manojtharindu11/Miner-Safety-Helmet/Images/repeater.jpg

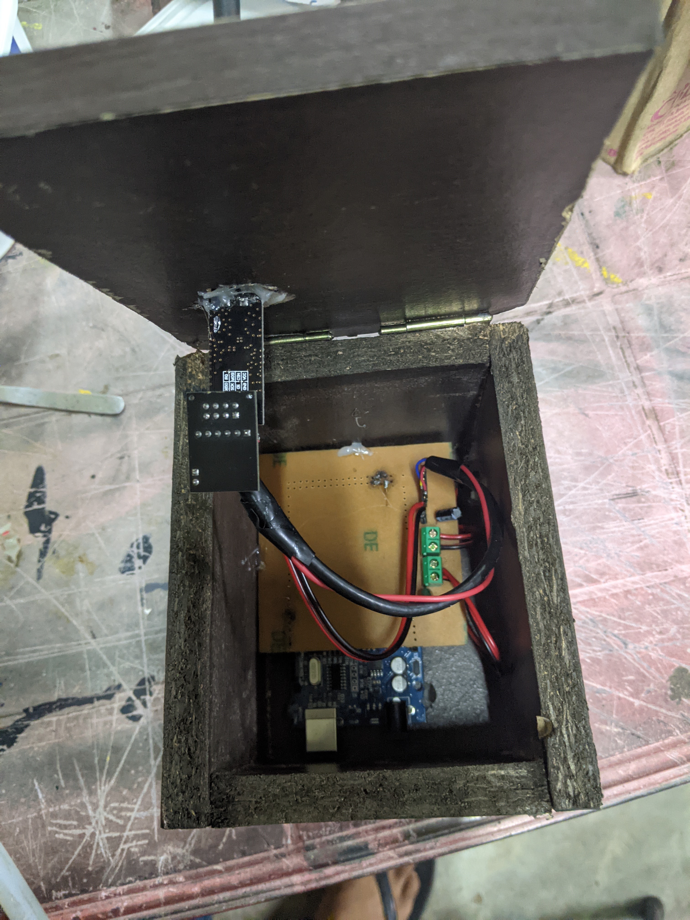
Images/repeater.jpg
