manojtharindu11/Miner-Safety-Helmet/Images/Pic1.jpg

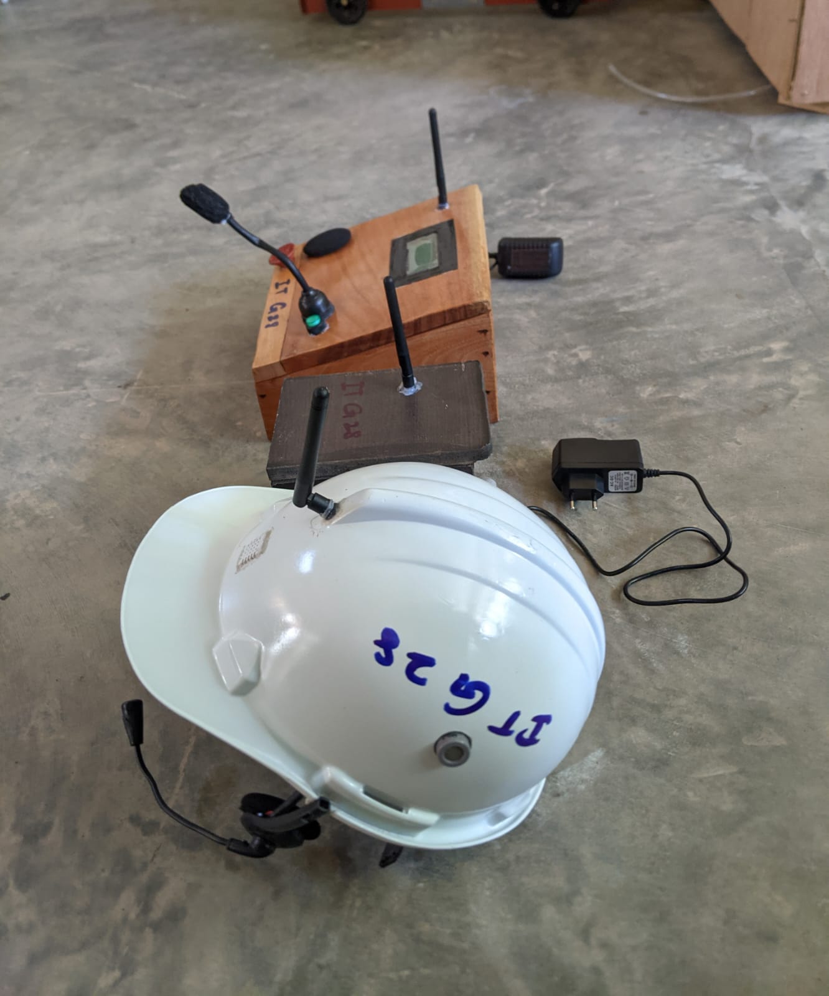
Images/Pic1.jpg
