manojtharindu11/Miner-Safety-Helmet/Images/receiver.jpg

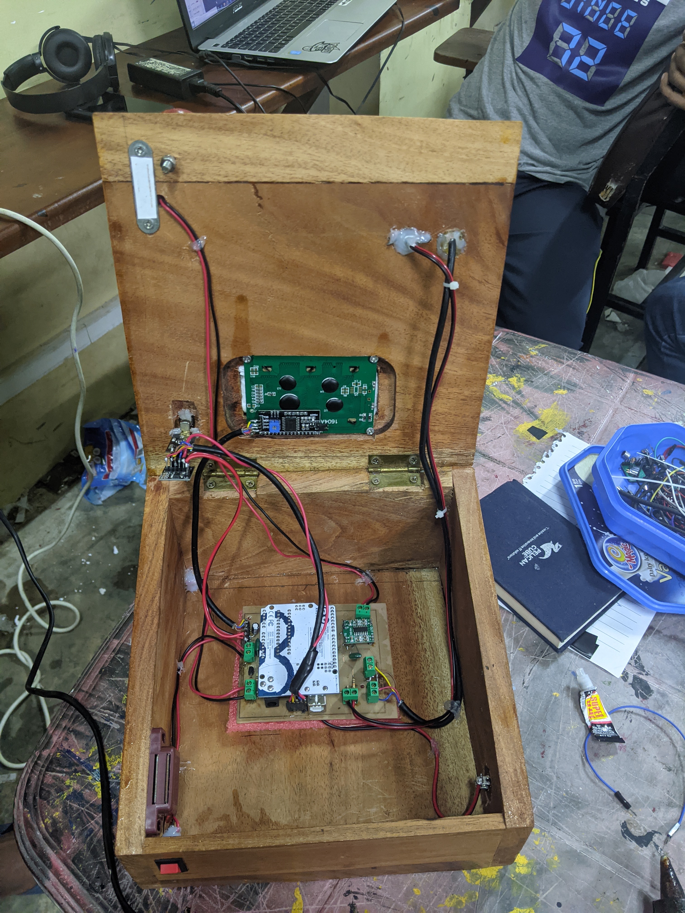
Images/receiver.jpg
