manojtharindu11/Miner-Safety-Helmet/Images/transmiter.jpg

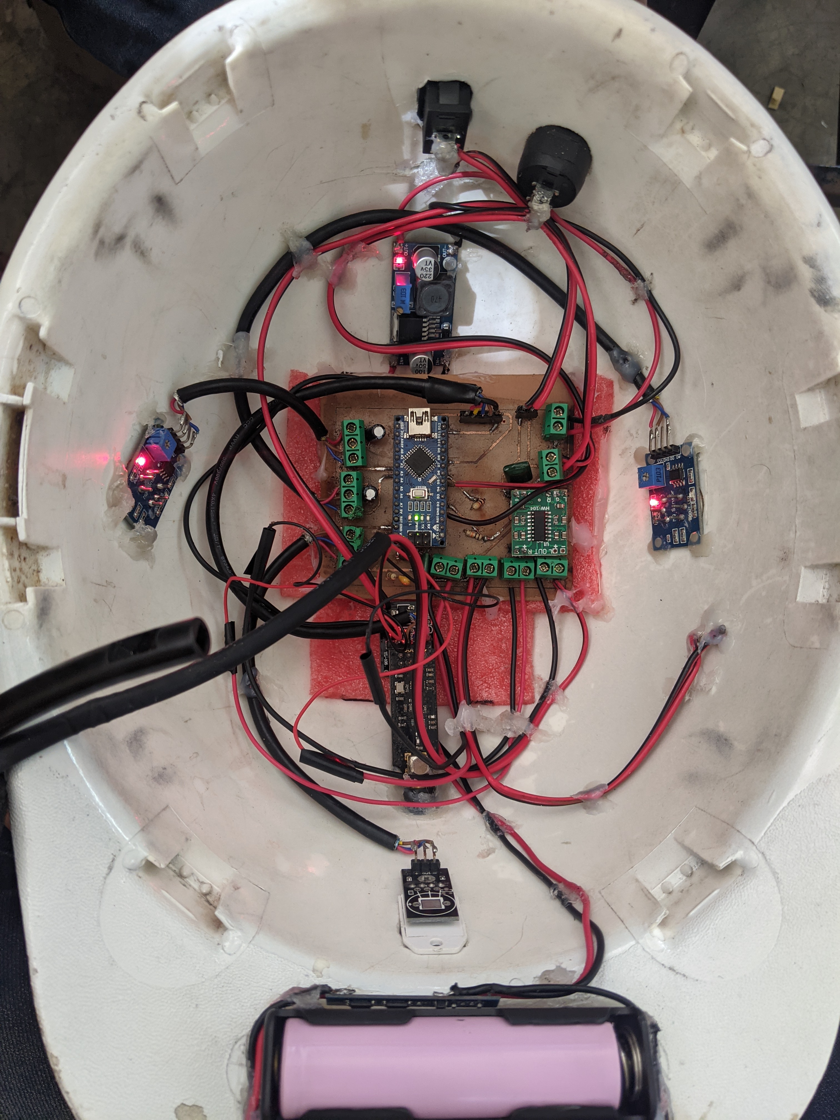
Images/transmiter.jpg
