manojtharindu11/Miner-Safety-Helmet/PCBs & Schematics/Schematic_repeater_2023-06-20.png

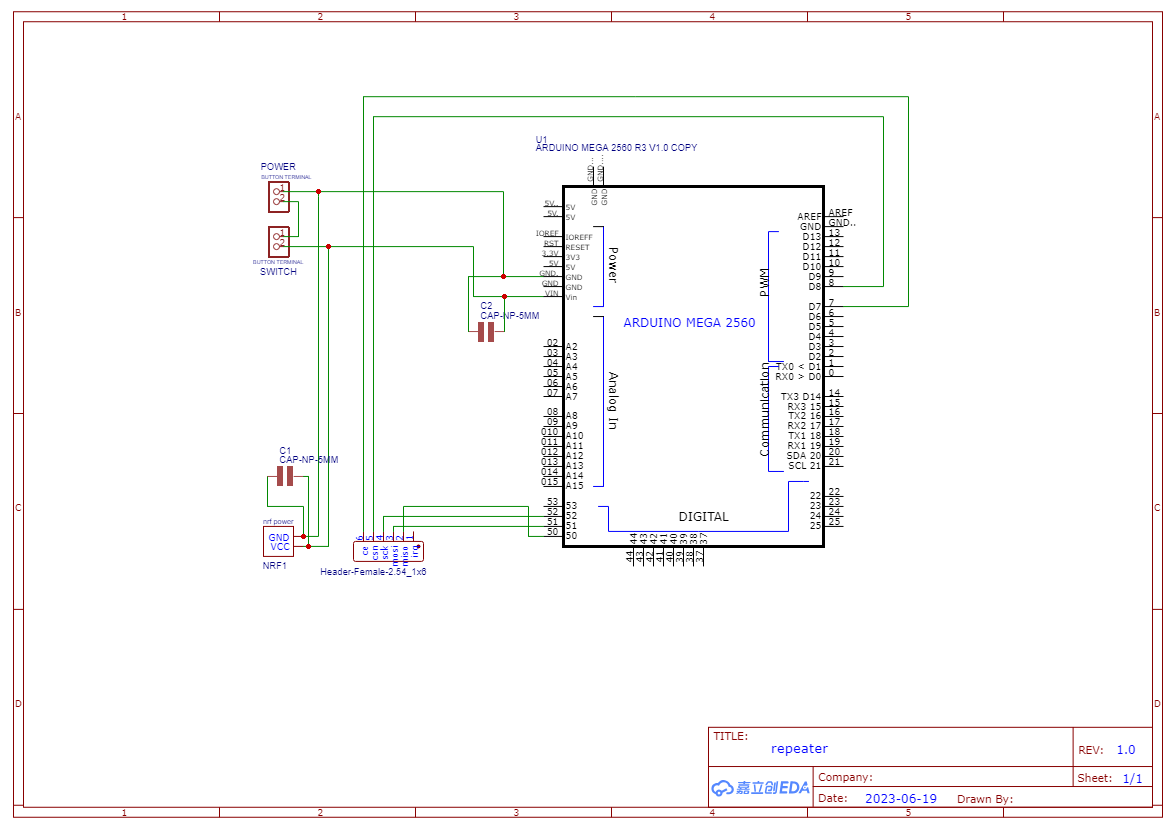
PCBs & Schematics/Schematic_repeater_2023-06-20.png
