manojtharindu11/Miner-Safety-Helmet/PCBs & Schematics/Schematic_transmitter_2023-06-20.png

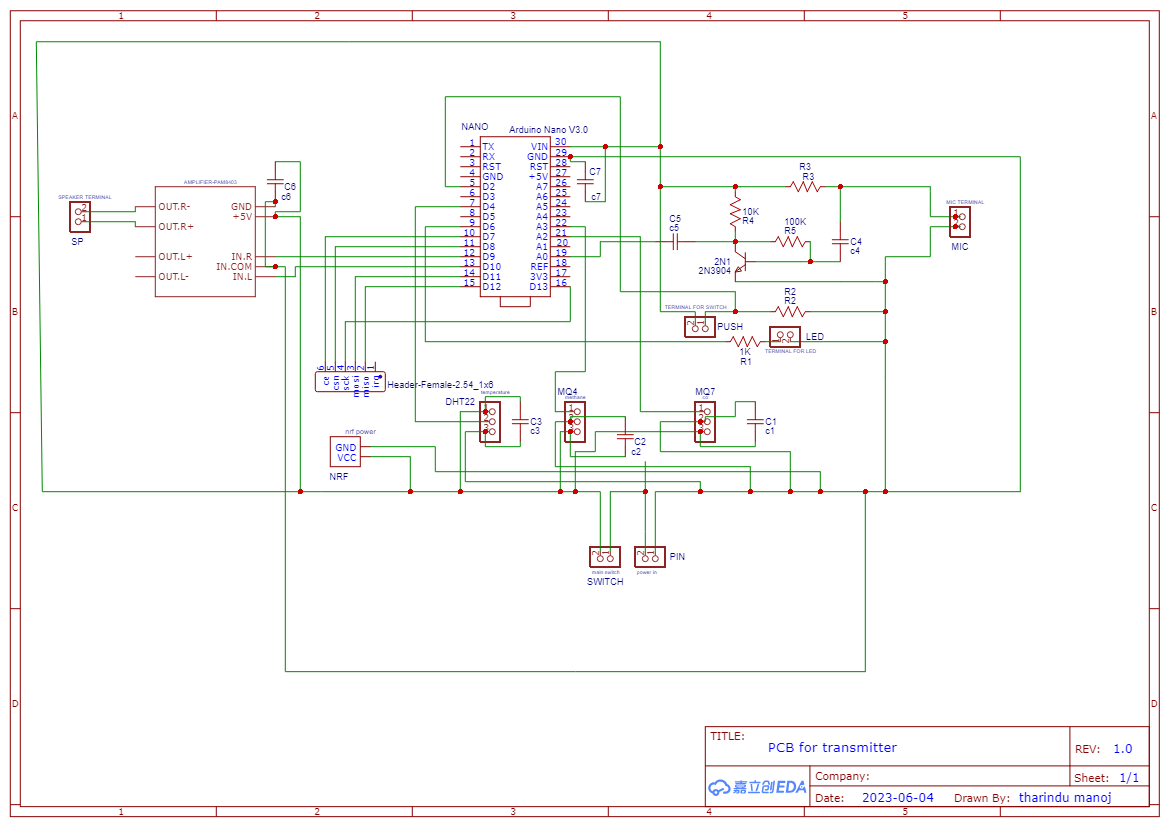
PCBs & Schematics/Schematic_transmitter_2023-06-20.png
