manojtharindu11/Miner-Safety-Helmet/PCBs & Schematics/PCB_PCB_receiver_2023-06-20.pdf

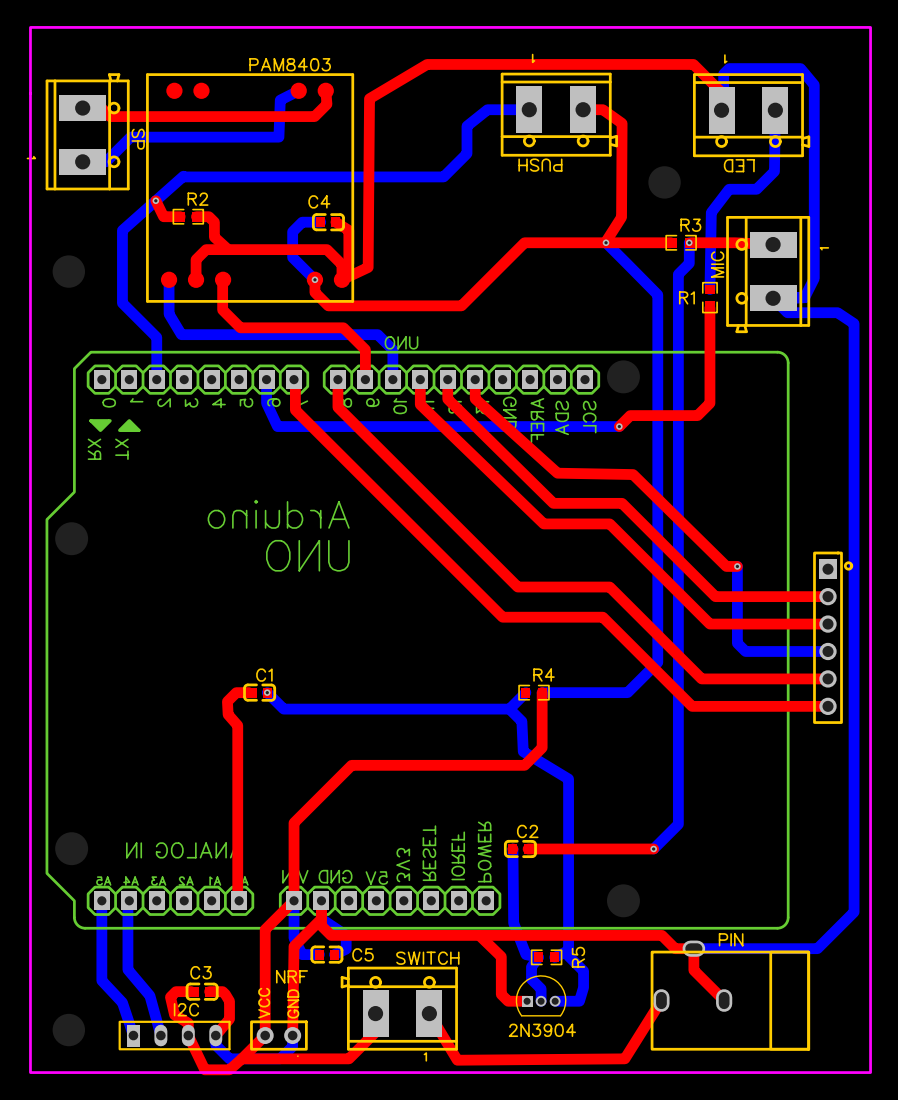
[picture p18: page 1]
