manojtharindu11/Miner-Safety-Helmet/PCBs & Schematics/PCB_PCB_repeater_2023-06-20.pdf

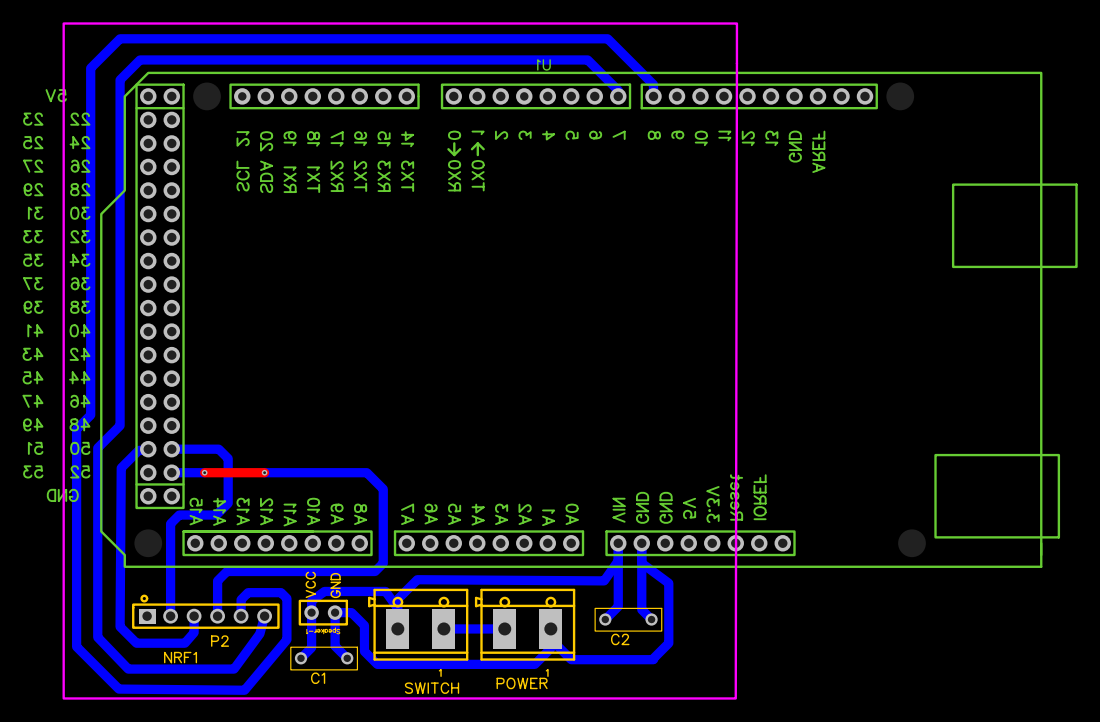
[picture p19: page 1]
