manojtharindu11/Miner-Safety-Helmet/PCBs & Schematics/PCB_PCB_transmitter_2023-06-20.pdf

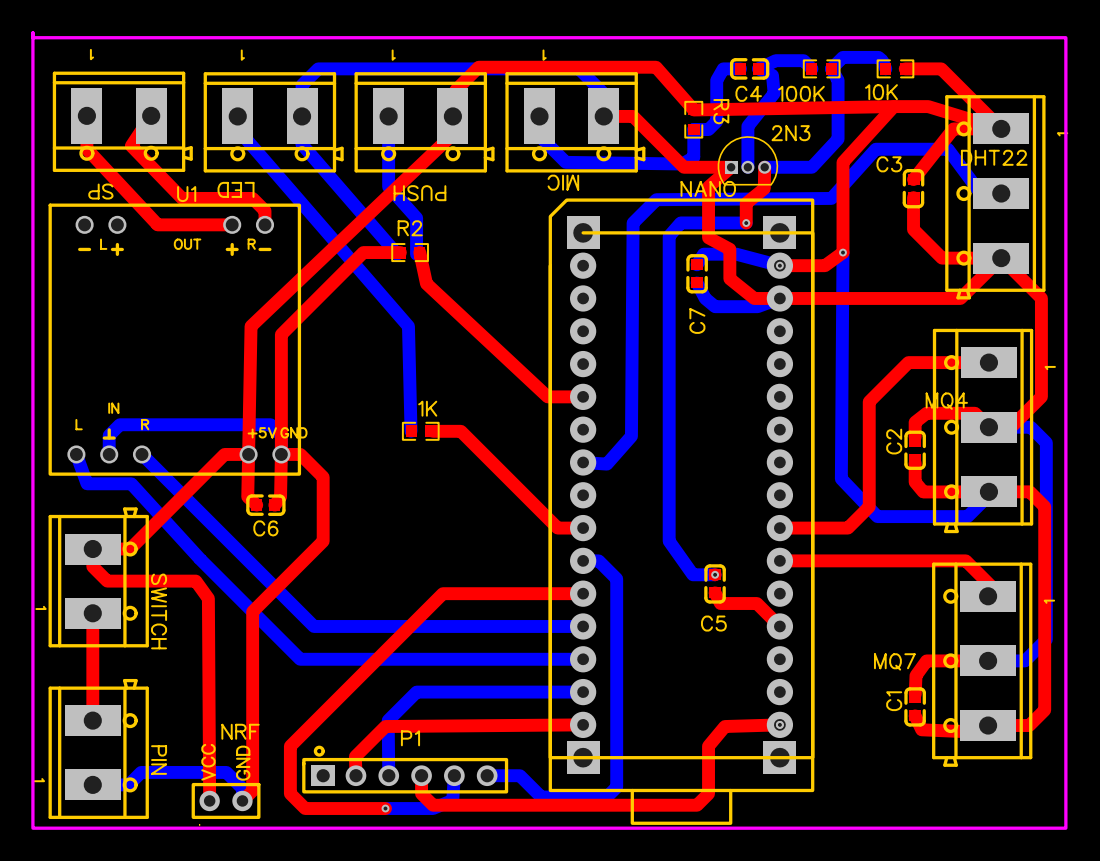
[picture p20: page 1]
